gyarab/chytry-lock/3dmodels/3dboxmodel.,v1.obj

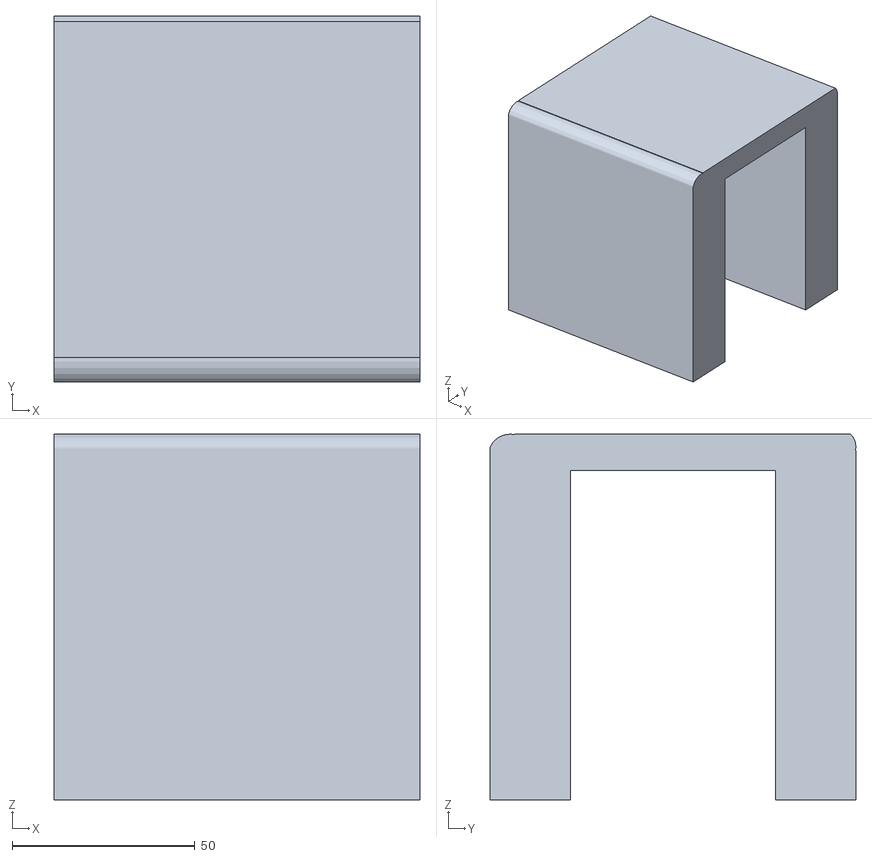
[picture p5: CAD file, 2019-06-05]
3dmodels/3dboxmodel.,v1.obj
100.0 x 100.0 x 100.0
