gyarab/chytry-lock/3dmodels/drzak_klic.obj

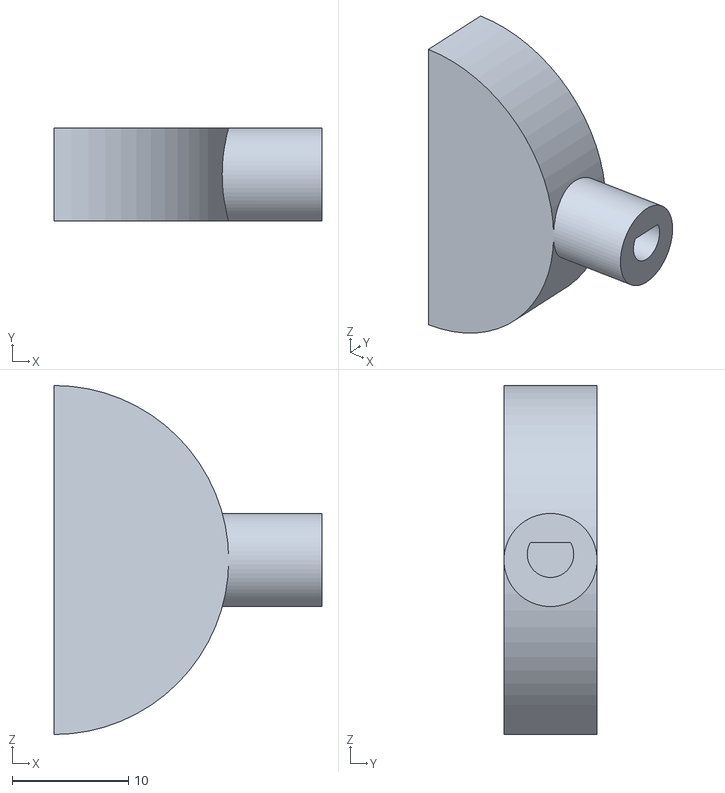
[picture p6: CAD file, 2019-05-30]
3dmodels/drzak_klic.obj
23.0 x 8.00 x 30.0
