gyarab/chytry-lock/3dmodels/drzak_motor.obj

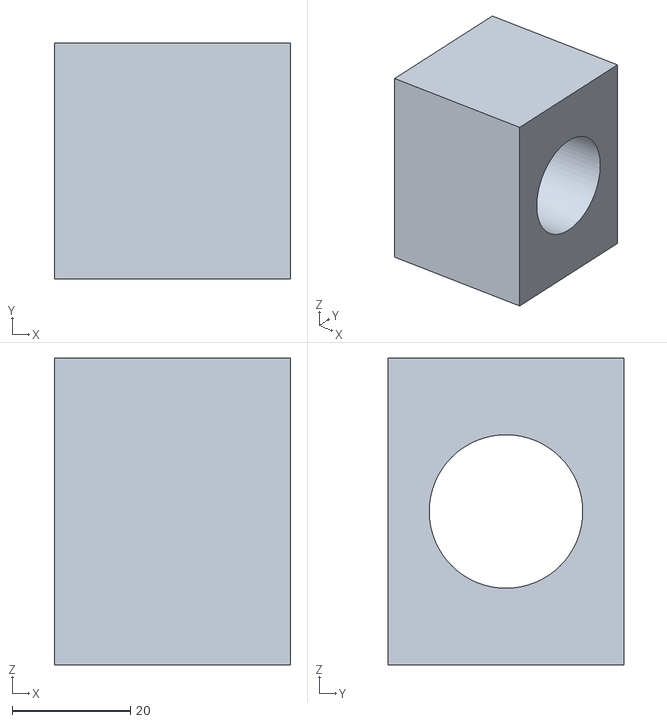
[picture p7: CAD file, 2019-05-30]
3dmodels/drzak_motor.obj
40.0 x 40.0 x 52.0
